granzscientific/bm1-battery-monitor/hardware/REV_C/BoxLid.stl

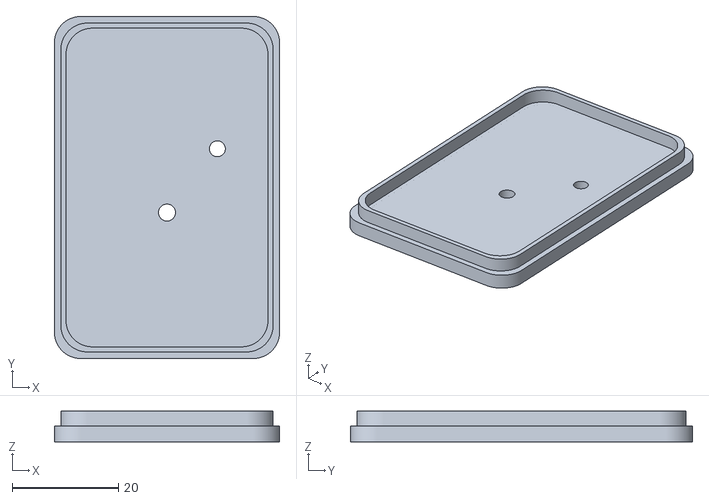
[picture p1: CAD file, 2026-03-30]
hardware/REV_C/BoxLid.stl
42.5 x 64.5 x 5.76
