granzscientific/bm1-battery-monitor/hardware/REV_C/Box.stl

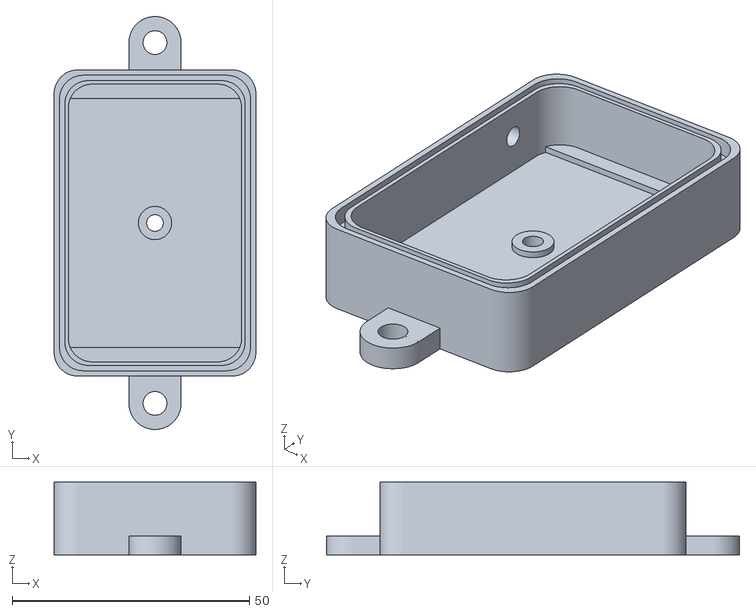
[picture p2: CAD file, 2026-03-30]
hardware/REV_C/Box.stl
42.5 x 87.0 x 15.3
