granzscientific/bm1-battery-monitor/(commit log)

2026-01-28 Updated timeout before sleep when not connected to HA
    Updated timeout to 5min before going into deep sleep when the device
    hasn't been added to Home Assistant.
2026-01-28 Added reset button for Home Assistant.
2026-01-30 Disabled filter for Battery Voltage for testing.
2026-01-30 Added calibration for battery voltage.
2026-02-09 Added beep when battery is low
    - Added beep every 5 seconds if battery is below configured
    threshold. This only happens while not in deep sleep of course.
    - Set LED on when device is unconfigured for indication to the
    end user.
2026-02-09 Refined when LED is on and when samples are taken
2026-03-03 Low battery alarm to support 24V and 12V systems
2026-03-03 Recalibrated voltage table
2026-03-03 Change battery voltage filter to use lambda instead of table
2026-03-03 Added car battery icon
2026-03-10 Fixed battery level indicator
    - Fixed batter level % indicator
    - Added text sensor for detected system type
    - Added WiFi signal strength indication
    [base.yaml]
2026-03-30 Added case STLs and manual
    [Box.stl, BoxLid.stl]
2026-03-30 Added enclosure material spec
